ferrance/open-scales-project/readme.md

# Open Scales Project

## Goals

I started playing around with CNC machining because I'm a lefty and
a knife guy. At some point I picked up a left handed spyderco PM2. 
It was great that they made one. But it only came in one handle 
and one steel, while the right hand version has dozens or possibly
even hundreds of variations.

That knife started me down the CNC rabbit hole. I buit several 
machines until I had one that was accurate enough to make scales.
Now I spend my weekends making new scales, typically lefty 
friendly, for various knives. The results are here.

## Fininshed Knives

These are scales that you should be able to get working 
with the files in this repository.

- [Zero Tolerance 0640](zt-0640/readme.md)
- [Spyderco Smock](spyderco-smock)

## Works in Progress

These are works in progress. Some are closer to being done than 
others.

- [Civivi Elementum](civivi-elementum) (nearly done)
- [Spyderco Manix 2](spyderco-manix) (nearly done)
- Kizex Cormorant XL
- Spyderco Paramilitary 2
- milled CME (compression lock extender)

## Misc

- Planer
