ferrance/open-scales-project/civivi-elementum/readme.md

# Civivi Elementum

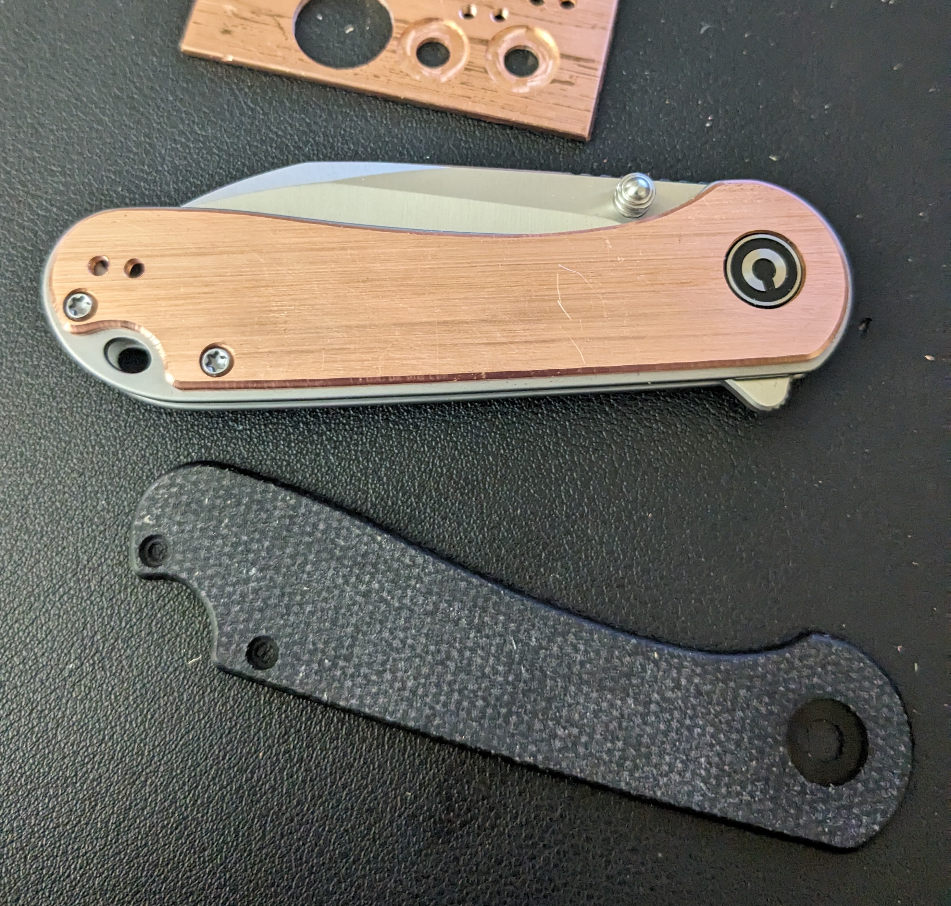
[picture p2: civivi-elementum/images/civivi-elementum.jpg]
spyderco manix 2


The elementum is a fairly simple scale design. It is a liner lock
and smaller than the liners. The scales (at least on mine)
are a tiny bit over 2mm thick.

The lock side scale has a little milling on the inside to allow the liner 
lock to move when the blade is closed.

The non-locking side has a notch in the pivot that serves 
much the same function as a D-slot would in other knives.
It is also shaped differently than the lock side, at least
on my wharncliffe model, allowing
a little more room for access to the thumb stud.

The edges appear to be chamfered. I'm doing a 1mm chamfer with a 
90 degree bit.

## Setup

The non-locking side is one-sided and the lock side is milled on both sides. 
I prep this with blue painters tape on one side, then use superglue to secure it 
to some waste board of the same width as the scale but a little taller. For the 
two-sided one, I put the tape and glue on after cutting the first side.

I was able to find 2mm stock (copper!), so I did not need to 
machine it to the correct height.
For test pieces in woold I use the planer at 2.0mm, 140x42 to get the 
material to the correct height.

## Making the cuts

If you have a piece of stock that is the correct thickness, this
scale is very easy to cut, requiring only one tool change.

I use a 2mm endmill for everything other than the chamfers. 
Basically I just have that tool cut all the holes and the part.
The rest is done with a 6mm, 90 degree chamfer bit. 

**Lock side**. Set the zero on the left alignment hole.
I like to put blue tape on the spoil board at this point 
so that the alignment holes get drilled through it. 
But not on the copper because it would affect the Z zero.
Cut the inside, which is the two holes and the liner
lock relief cutout.

Remove piece and tape the side you just cut. Verify that
your 1/8" rods fit all the holes. Apply superglue and place
the piece, using the two holes to get the alignment right.
(I have done this without glue and it worked fine with 
screws through the pivot and other two holes. So maybe
the tape isn't necessary.)

I break the other side into two programs. First, do all the
holes. This allows you to use them to secure the workpiece
before doing the part itself. I found that #2 screws fit
for the small screws, and there are lots of options for the
pivot screw. Once everything is secure you can remove the
alignment rods if you wish.

The pivot is 1.2mm deep. The other two are 1.5mm.

After securing the piece, I run a program that just does the
edge and chamfer.

**Non-lock side**. This side is much easier. Simply tape and
glue the piece. For copper, I also used screws to secure the
copper to the waste board. Cut the holes, then pause and use some
screws to further secure the piece. Then cut the outline.
For the copper, I used trochoidal milling on the part.

## Misc notes

To make this knife left hand friendly, I needed to mill these scales 
out of metal and drill and tap the two holes for the clip.
The clip screws are M2.5. This means use of a 2.05mm drill.
I elected to mill 1mm deep 1mm diameter holes to mark the clip
hole positions, then drill and tap by hand.

The non-lock side has a tiny notch to retain the pivot in place.
It is about 2mm wide. So far I have not bothered to implement this
since I'm able to use the pivot without it.

I'm using 1.5mm for the inset parts around the pivot and spacers. 
Everything else is 2.5mm deep. The chamfer is 0.8.

I've had the pivot hole come out just a tiny bit too small.
The pivot is 5mm so if that happens to you just hit it with a
5mm drill.
