ferrance/open-scales-project/zt-0640/readme.md

# Zero Tolerance 0640

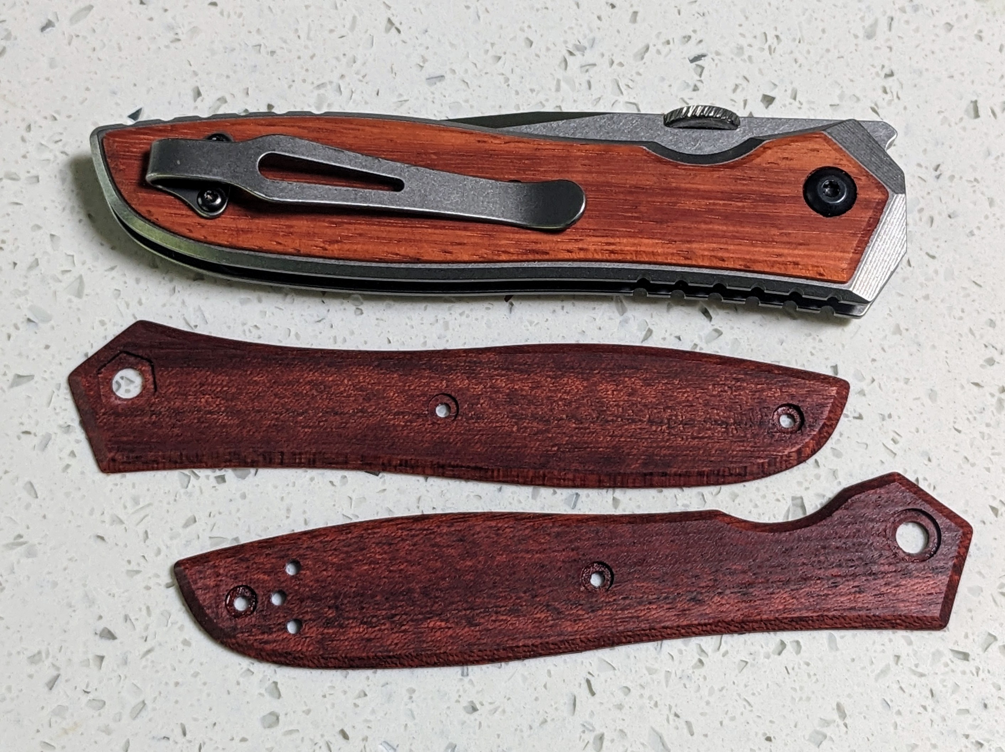
[picture p3: zt-0640/images/zt0640-ironwood-scales.jpg]
Front of stock scale


## Original Knife

The ZT0640 is a relatively large (8.5") titanium framelock on washers. It sports a 20CV blade and
uses a thumb disk for deployment. The green carbon fiber scales cover the frame lock, making it harder
to inadvertently apply pressure to the lock when deploying, which is excellent. But the green is 
hideous, so a scale replacement is mandatory. Sadly, this knife finally seems to be discontinued.

[BHQ Link](https://www.bladehq.com/item--Zero-Tolerance-Emerson-0640-Folding--92047)

The 0640 uses 2mm thick green carbon fiber scales (there was also a limited edition in black). The lock
side has two cutouts on the back; the non-lock side is simple and has no cutouts. 

## The scales

Given the simplicity of this scale, I've chosen to render it as an SVG. 

For either side, I start with a 1.5x6" piece that is about 1/8" thick, then
machine it down to a 2mm thickness.

### The non-locking side

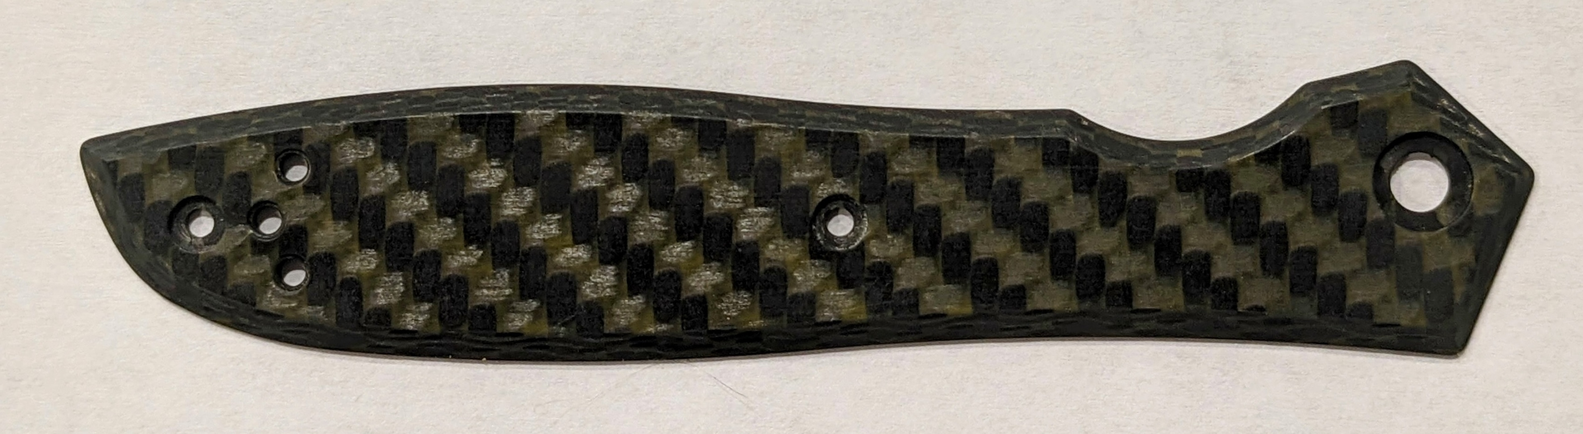
[picture p4: zt-0640/images/zt640-front.jpg]
Front of stock scale


The non-locking side requires only a few holes and a bevel. This can 
be machined with two tools. I have used a 2mm end mill for everything except
the final bevel. The final bevel uses a 120 degree chamfer mill. The 
bevel should be set to 2.5mm in ESTLCam.

The pivot and the two screws that hold the knife together have 1mm counterbores.

ESTLcam does the bevel after it cuts out the part, so you need to make sure
that the piece is adhered to the spoilboard. With softer materials I haven't 
had any problem with the painters tape and superglue method. But you could
also machine the holes first and then put some screws through them, which
I'll probably try when I make a pair of these out of copper.

### The lock side

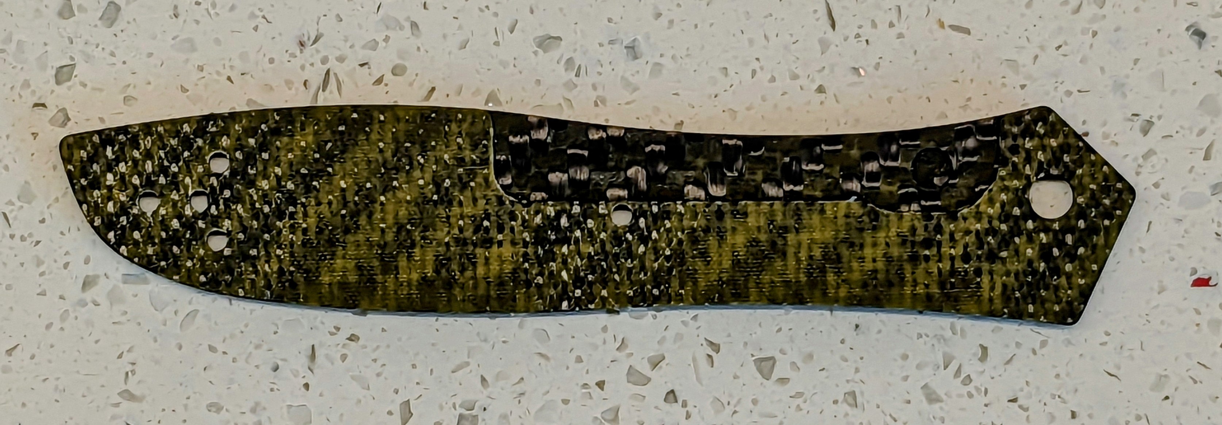
[picture p5: zt-0640/images/zt640-lockside-back.jpg]
Back of lock-side scale


This is the more difficult of the two scales. Since there is milling
on both sides, there are two holes on either side that are used to 
position the piece. These are sized for 1/8" brass rod that I use. 
The gcode uses the center of the left of these two holes as its origin.
The depth of the holes should be at least 1mm greater than the thickness
of the scales. 

For the alignment holes to work, you need a piece of spoilboard
and it needs to stay in the same spot the entire time.

For the first pass, I secure the piece with tape and glue and 
machine to a height of 2mm. 
I then mill the back side of the scale, which just includes the 
cutout for the lock and the positioning holes. 
I use a 2mm mill here.
The large cutout for the lock is 0.5mm deep and the small circle for
the detent ball is 1mm deep. The origin is the left positioning hole.

I found it useful to add the following to the end of the file to move
the spindle out of the way so I can flip the piece:

```
G00 X60 Y50
```

Before the second pass, you will need to flip the piece over and align
using the holes and brass rod. But before you do that, apply some tape and adhesive.
Like the non-lock-side scale, this operation will cut the part out before it 
applies the bevel.

For the second operation, flip the SVG vertically in ESTLCam (since you flipped the
workpiece vertically after the first operation). Keep the origin at the
left positioning hole. Make sure that your start code does not reset the 
X and Y machine coordinates--you want to retain them from the first pass.

Once the piece is positioned and the glue has adequately set, start this
operation with a 2mm mill. There is a tool change at the end for the 120
degree bevel. The bevel depth in estlcam should be 2mm.

There are some tight tolerance in the middle screw since it has a cutout 
on the opposite side. I find it useful to do the Z calibration at or near
that hole.
