ferrance/open-scales-project/kizer-cormorant-xl/readme.md

The original scales on the cormorant XL are about 4.5mm thick.
The XL has inset liners. It is held together by the pivot and
a single screw in the back. It has a reversible clip.
