ferrance/open-scales-project/kizer-cormorant-xl/cormorant 1.pdf

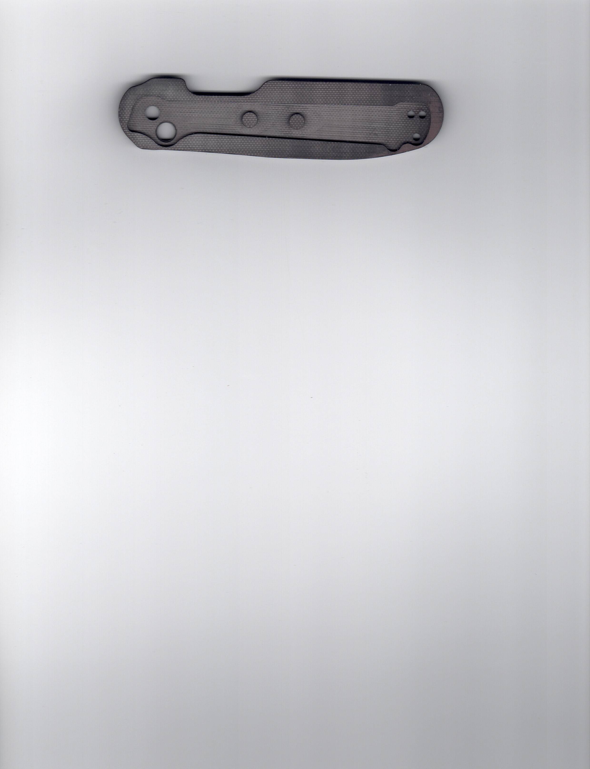
[picture p7: page 1]
