ferrance/open-scales-project/kizer-cormorant-xl/cormorant 2.pdf

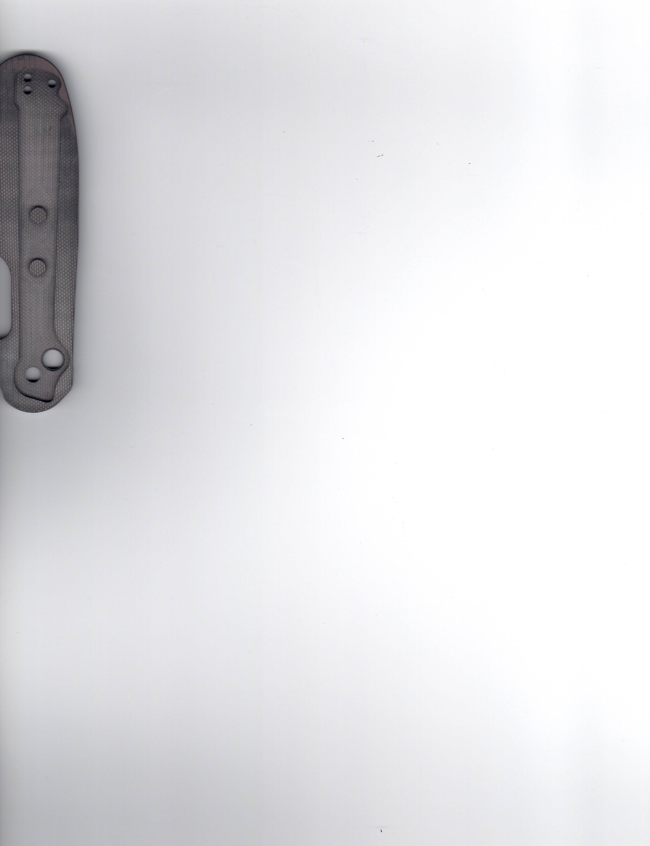
[picture p8: page 1]
