ferrance/open-scales-project/kizer-cormorant-xl/cormorant 3.pdf

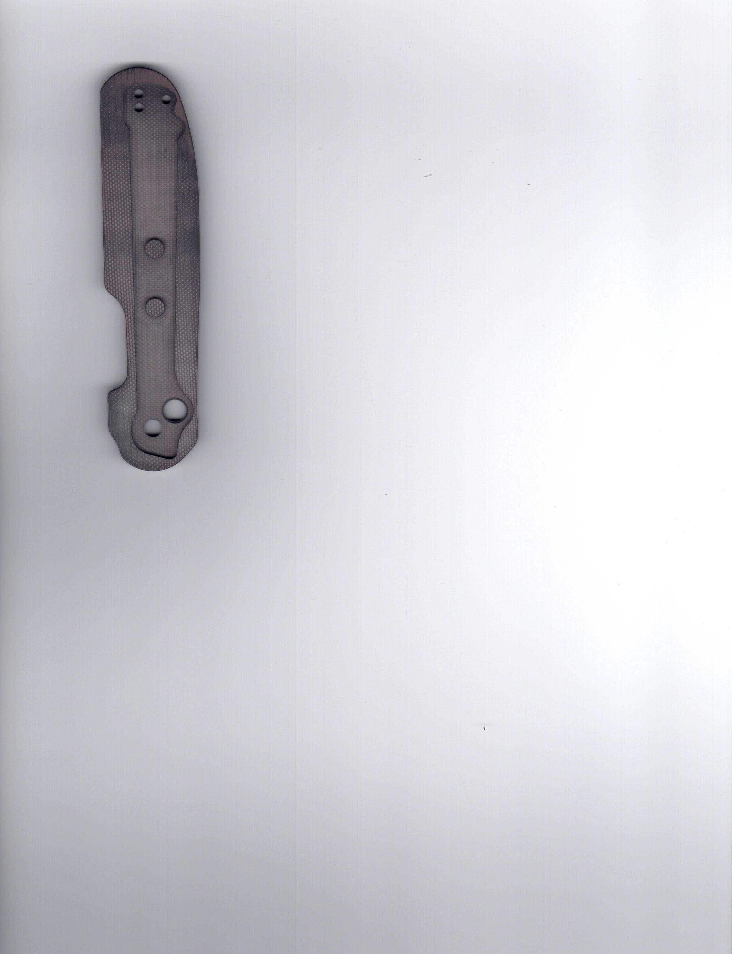
[picture p9: page 1]
