ferrance/open-scales-project/civivi-elementum/images/inside.jpg

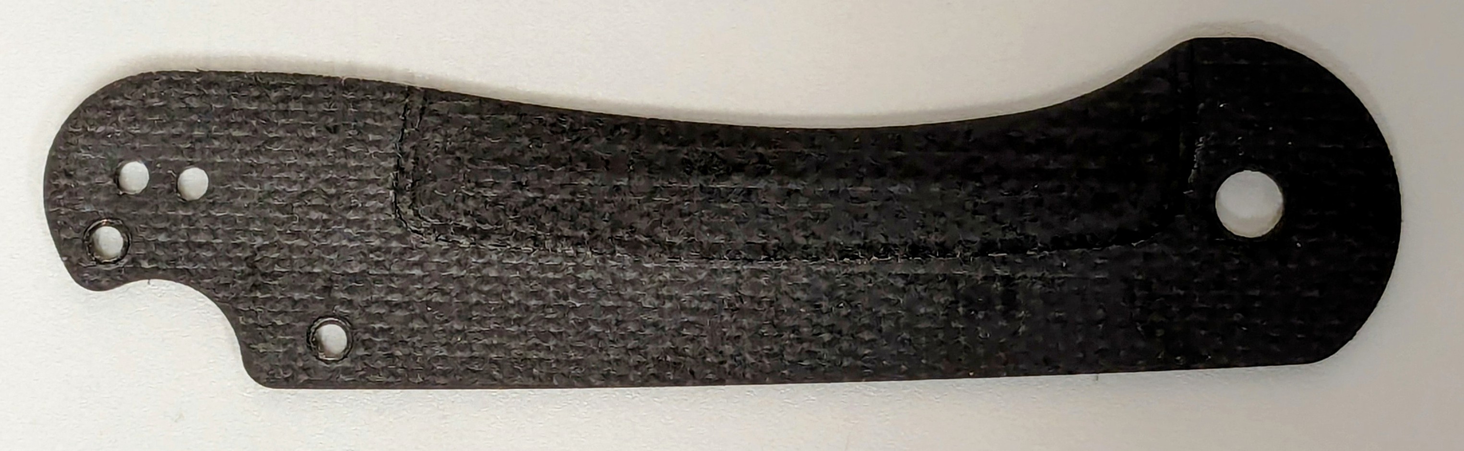
civivi-elementum/images/inside.jpg
