ferrance/open-scales-project/civivi-elementum/images/outside-no-lock.jpg

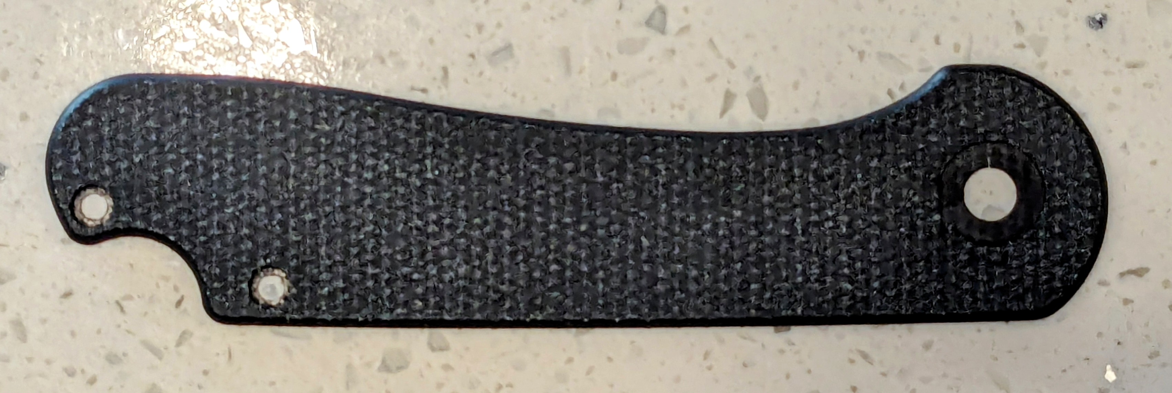
civivi-elementum/images/outside-no-lock.jpg
