ferrance/open-scales-project/civivi-elementum/images/outside.jpg

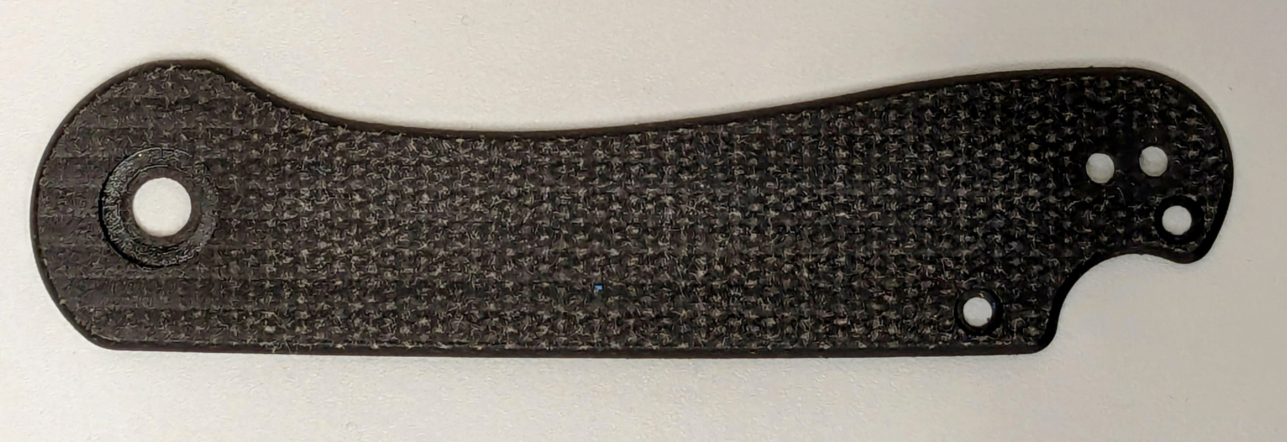
civivi-elementum/images/outside.jpg
