ferrance/open-scales-project/spyderco-manix/manix-scale.jpg

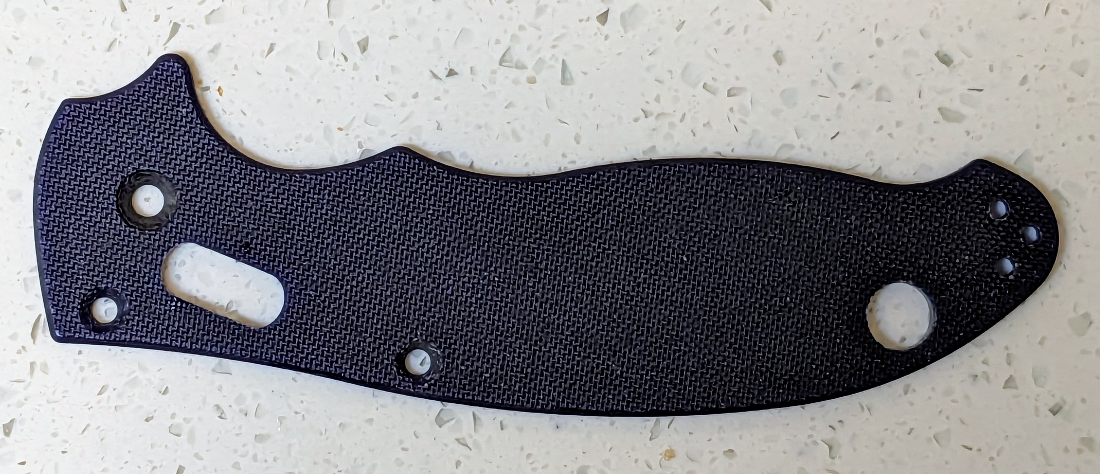
spyderco-manix/manix-scale.jpg
