ferrance/open-scales-project/spyderco-smock/images/button-inside.jpg

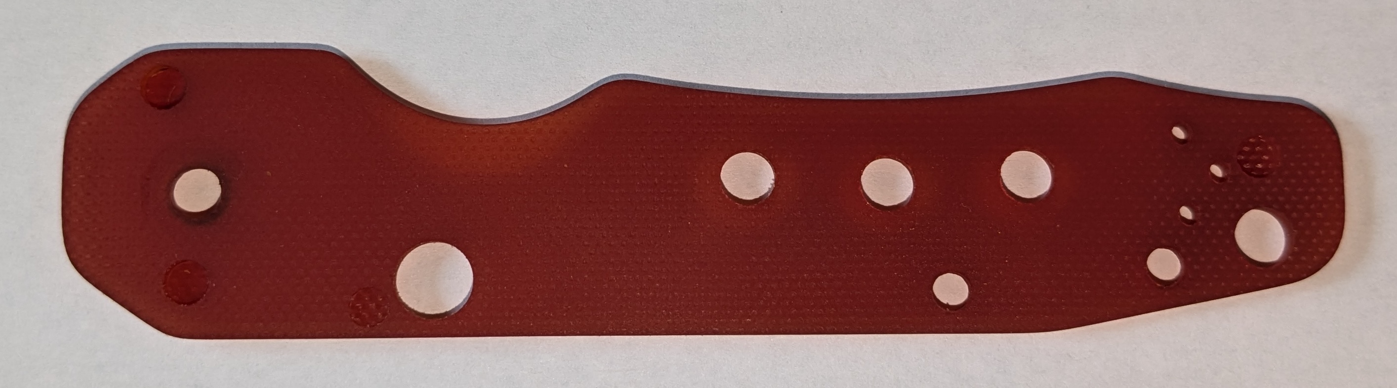
spyderco-smock/images/button-inside.jpg
