ferrance/open-scales-project/spyderco-smock/images/button-outside.jpg

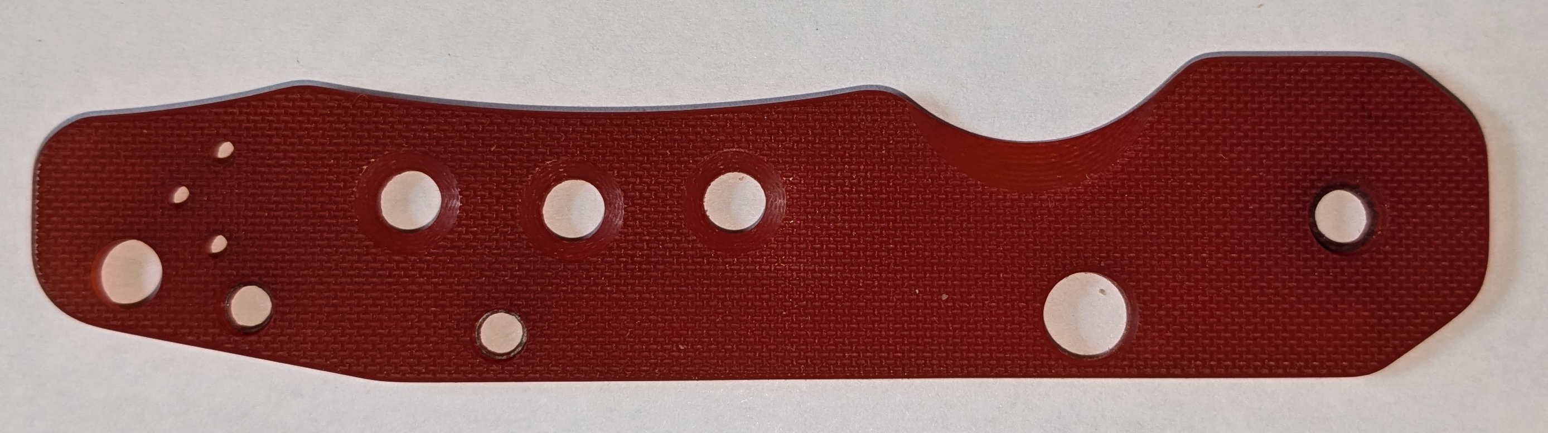
spyderco-smock/images/button-outside.jpg
