ferrance/open-scales-project/spyderco-smock/images/left-inside.jpg

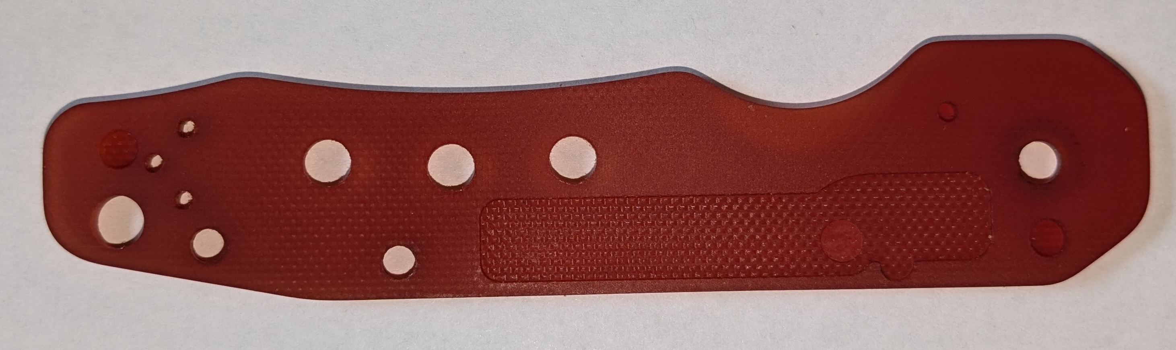
spyderco-smock/images/left-inside.jpg
