ferrance/open-scales-project/spyderco-smock/images/left-outside.jpg

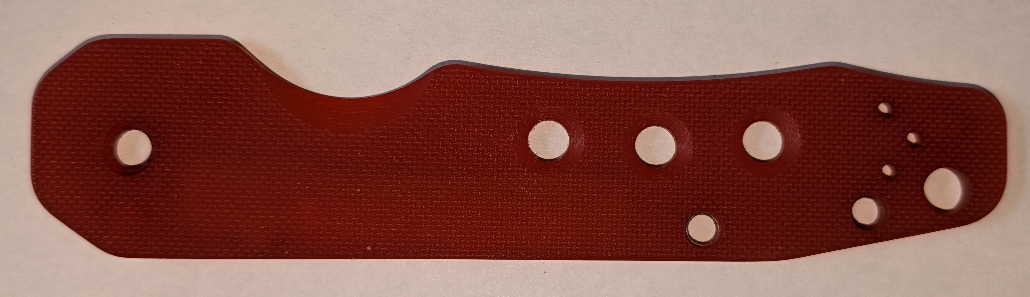
spyderco-smock/images/left-outside.jpg
