ferrance/open-scales-project/(commit log)

2023-11-12 finally got the holes right
2024-11-24 tweaking holes
